king-aedred/planty/docs/hardware.md

# Planty – Bauteilliste

| Bauteil | Funktion | Preis |
|---|---|---|
| ESP32 | Mikrocontroller (WLAN + Bluetooth) | 5€ |
| Capacitive Soil Moisture Sensor V2.0 | Bodenfeuchtigkeit messen | 2,50€ |
| XIAO Logger HAT mit DS18B20 & BH1750 | Temperatur, Licht usw. | 7€ |
| LIPO 3,7 V Akku 400mAh  | Akku | 6€ |
| Perfboard | Platine für Handmontage (Beta) | |
| Gehäuse (3D-Druck) | Schutz/Optik des Sensors | |
| Jumper-Kabel / Stiftleisten | Verkabelung | Gesamt: 20,5€ |
