king-aedred/planty/docs/SCREENS.md

# Callgreen App: Screens und Features

Stand: 2026-10-26 · Arbeitsliste für die UI-Runde. Gebaut wird in der Reihenfolge unten (User-Flow), Screen für Screen im Browser (`http://100.86.32.59:8099`).

## Entscheidungen (26.10.)

- **4 Tabs** bleiben: Pflanzen, Nachrichten, Sensoren, Einstellungen.
- **Sensor-Detail** wird eine eigene Seite. Das Pflanzen-Detail zeigt nur noch eine Sensor-Zeile mit Link.
- **Gießen:** keine Knöpfe „Jetzt gießen“/„Gegossen“. Kritische Pflanzen zeigen einen Hinweis („Braucht Wasser“). Quittieren + Kontrolle per Messung (Charakter-Reaktion) ist ein späteres Feature.
- **Filter und Standort:** später, zusammen. Filter-Knopf vorerst entfernen.
- **Pflanze ohne Sensor:** bleibt erlaubt, braucht einen eigenen Zustand.
- **„Passwort vergessen“:** wird jetzt gebaut.
- **Chips „Automatische Analyse“ / „Sofort-Tipps“:** gewollt, aber erst später mit echtem Inhalt. Vorerst entfernen.
- **Entfällt:** „Messzeit“ in den Einstellungen (gespeichert, aber nirgends genutzt; die Firmware hat einen festen Messplan), Burger-Menü.

## Screens (Soll), in Bau-Reihenfolge

Fertig (UI, 28.10.): 0 Willkommen, 1 Login, 2 Registrieren, 2b Code, 3 Passwort vergessen.
Baseline 29.10.: Onboarding-UI (4) komplett inkl. Kanäle; Dashboard (6) als adaptives Layout (1 Pflanze = Bühne, wenige = Bühne + Liste, viele = Suche + „Braucht dich“/„Alles gut“), Gesamtbild mit Tab-Leiste, Nachrichten, Sensoren, Einstellungen unter `/preview/7-app` (Beispieldaten, noch nicht verdrahtet).
Detailseiten 29.10. (im Gesamtbild antippbar): Pflanzen-Detail, Pflanzen-Einstellungen, Sensor-Detail, Profil, Benachrichtigungen; Pflanze hinzufügen und Sensor koppeln als Modi des Onboarding-Ablaufs (`mode`). Bausteine in `components/screens/`. Echte Clerk-Wege für Passwort vergessen und Code beim Login noch mit Testkonto prüfen.

**Phase A (31.10.): echte App verdrahtet.** Tabs (Dashboard adaptiv, Nachrichten, Sensoren, Einstellungen) mit Markenleiste, Pflanzen-Detail mit Verlauf aus `device_readings`, Pflanzen-Einstellungen, Sensor-Detail mit Befehlen, Profil (Clerk), Benachrichtigungen (Kanäle, Erreichbarkeit, Max/Tag), Onboarding nach der ersten Anmeldung (`users.onboarding_done`), Pflanze hinzufügen, Sensor koppeln/zuordnen, Erfolge aus den Tagesauswertungen. Push-Erlaubnis nur noch im Onboarding bzw. beim Einschalten. Offen für Phase B (Testtag mit Handy + Sensor): neue BLE-Schritte statt des bestehenden Kopplungs-Bausteins, Push/Telegram am Gerät prüfen, Befehle am echten Sensor.

**Phase B (31.10.): echte Kopplung hinter den neuen Schritten.** `components/onboarding/ble-pairing.ts` (`createBlePairing`, Logik aus dem alten `ble-provisioning.tsx`, das samt `legacy-pairing.tsx` entfernt ist) erfüllt `PairingAdapter`; `hooks/use-ble-pairing.ts` verdrahtet Claim-Token (`devices.createClaimToken`) und Backend-Rückmeldung (`devices.getClaimStatus`). Onboarding, Pflanze hinzufügen und Sensor koppeln nutzen es; die Vorschau bleibt bei `mockPairing`. Fälle: Berechtigungen (Bluetooth, Android auch Standort) mit Erklärung und Fehlertext im Einsteck-Schritt, mehrere Sensoren → Auswahl, Verbinden scheitert → konkreter Grund + „Nochmal suchen“, Sensor schon im WLAN → WLAN-Schritt entfällt („war schon verbunden“), falsches Passwort / WLAN nicht gefunden / Claim abgelehnt → zurück zur WLAN-Eingabe mit Text, BLE reißt ab → Backend-Rückfallebene 45 s. Noch nicht am Gerät getestet (Testtag).

| # | Screen | Inhalt | Änderung gegenüber heute |
|---|---|---|---|
| 0 | **Willkommen (App-Start)** | Logo-Animation (Mitte → oben), „Hast du schon ein Konto?“ → Registrieren / Anmelden | **neu**; Start ohne Login landet hier statt im Login |
| 1 | Login | E-Mail, Passwort, Google/Apple | Logo/Texte „Callgreen“; SSO prüfen (geht heute nicht) |
| 2 | Registrieren | Benutzername, E-Mail, Passwort ×2, Nutzungsbedingungen (Link → Blatt von unten, Inhalt folgt in `constants/legal.ts`) | Überschrift „Gib deiner Pflanze eine Stimme!“, Platzhalter raus |
| 2b | **Code eingeben** | 6 Ziffernfelder, prüft automatisch, wackelt bei falschem Code, „Code erneut senden“, „Zurück“ | **neu**; gemeinsam für Registrieren (E-Mail) und Login (neues Gerät) |
| 3 | **Passwort vergessen** | E-Mail → Code → neues Passwort → angemeldet (Clerk `resetPasswordEmailCode`); Link im Login | **neu** |
| 4 | Einstieg / erste Pflanze | Willkommen → Sensor koppeln → Art + Name → fertig | ohne Burger-Menü; klarer Schrittfortschritt |
| 5 | Sensor koppeln (BLE) | USB-Hinweis, Scan, WLAN (Liste, Vorschlag, QR), Warten, Fehler | anzeigen, mit welchem WLAN der Sensor schon verbunden ist; „Planty“-Texte raus |
| 6 | Dashboard (Tab Pflanzen) | Kompakt/Detail, Avatar, Messwerte, letzte Nachricht, „x von y Sensoren aktiv“, Pflanze hinzufügen | Filter, Standort, Gieß-Knöpfe, Deko-Chips raus; Zustand „ohne Sensor“; kritisch = Hinweis |
| 7 | Pflanzen-Detail | 3 Messwerte, Verlauf (Messgröße, Zeitraum, eigener Bereich), Charakter, Sensor-Zeile → Sensor-Detail | Sensor-Aktionen ausgelagert |
| 8 | Pflanzen-Einstellungen | Name, Art, Persönlichkeit, Schwellenwerte, **Pflanze löschen** | Löschen neu (heute nur über „Sensor übertragen“) |
| 9 | Pflanze hinzufügen | Mit/ohne Sensor, freier Sensor oder von anderer Pflanze übertragen, Art, Name | Texte/Optik |
| 10 | **Sensor-Detail** | Akku (%), WLAN/Signal, Firmware, zuletzt gesehen, nächste Messung, zugeordnete Pflanze; Jetzt messen, WLAN ändern, Werkseinstellungen, Entfernen | **neu** (Inhalt aus Pflanzen-Detail) |
| 11 | Sensoren (Tab) | Liste: im Einsatz / frei, → Sensor-Detail, Sensor koppeln | Zeile öffnet Sensor-Detail |
| 12 | Nachrichten (Tab) | Liste, gelesen/ungelesen, Systemhinweise (offline, Akku) | Optik, Leerzustand |
| 13 | Einstellungen (Tab) | Benachrichtigungen (Kanäle je Zustand, Ruhezeiten, Max/Tag), Telegram, Profil, Telefonnummer, Ausloggen, Dev Tools (nur Dev) | „Messzeit“ raus |

Übergänge Willkommen → Login/Registrieren und Login ↔ Registrieren ↔ Code: Logo bleibt/gleitet, nur die Box blendet aus und ein (`components/auth/auth-shell.tsx`).

Nebenher: Start-Spinner mit Timeout (~15 s, „Keine Verbindung“ + „Erneut versuchen“), Login-Pflicht für alle Routen im Web, restliche „Planty“-Texte.

Unverändert / außerhalb der Runde: Fake-Anruf (`demo-call`), Dev Tools, Vorschau-Seiten.

## Onboarding (Plan 28.10.)

Kommt einmalig nach der ersten Anmeldung (Feld `onboarding_done` am Nutzer; bestehende Konten mit Pflanzen gelten als fertig). Optik wie Auth: Kopf bleibt, jeder Schritt tauscht nur die Box, oben Fortschritt.

```
O1  „Schön, dass du da bist!“  [Ich habe einen Sensor] [Nur eine Pflanze anlegen] [Später → leeres Dashboard]
Sensor-Pfad:  A1 USB anstecken → A2 Suchen → A3 WLAN + Passwort → A4 Verbinden … → A5 „Sensor verbunden!“
Beide Pfade:  P1 Art suchen/selbst eingeben + Name (frei; leer = Standardname der Art)
              P2 Persönlichkeit (Fröhlich / Grummelig / Gelassen)
              P3 „Wie darf <Name> sich bei dir melden?“ Push · Telegram · Anruf (kommt bald)
                 → je gewähltem Kanal dessen Einrichtung (Push-Erlaubnis, Telegram-Code)
              P4 „<Name> ist bereit!“ → Übergang ins Dashboard (ohne Sensor: Hinweis, dass Messwerte fehlen)
```

Bausteine einmal bauen und wiederverwenden: A1–A5 = Screen 5 (Sensor koppeln), P1–P2 = Screen 9 (Pflanze hinzufügen). Vorschau mit simuliertem BLE/WLAN/Telegram.

Bau-Etappen: 1) Rahmen + O1 + P1–P4 (Pflanzen-Pfad) · 2) A1–A5 (Sensor-Pfad, BLE-Logik aus `ble-provisioning.tsx`) · 3) Kanäle (Push, Telegram) · 4) echte Weiche nach dem Login + `onboarding_done` im Backend.

## Später

- Gießen quittieren mit Kontrolle über die nächste Messung und Charakter-Reaktion
- Standort pro Pflanze + Filter/Sortierung im Dashboard
- „Automatische Analyse“ / „Sofort-Tipps“ mit echtem Inhalt
- Anruf als Kanal
