king-aedred/planty/hardware/enclosure/animation_frames.png

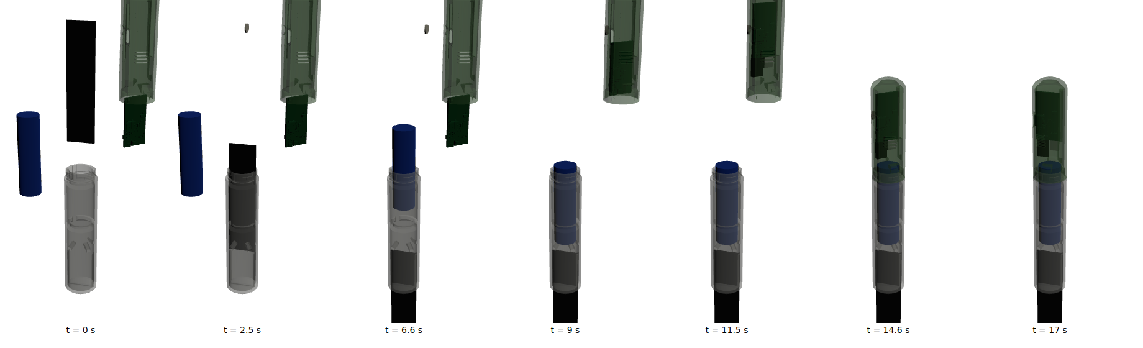
hardware/enclosure/animation_frames.png
