king-aedred/planty/hardware/enclosure/window.stl

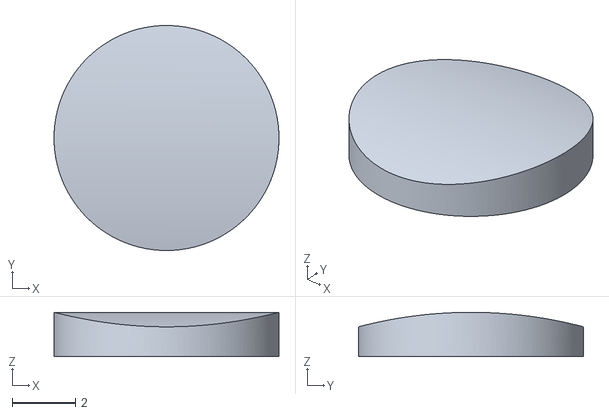
[picture p2: CAD file, 2026-11-04]
hardware/enclosure/window.stl
7.10 x 7.10 x 1.40
