king-aedred/planty/hardware/enclosure/head.stl

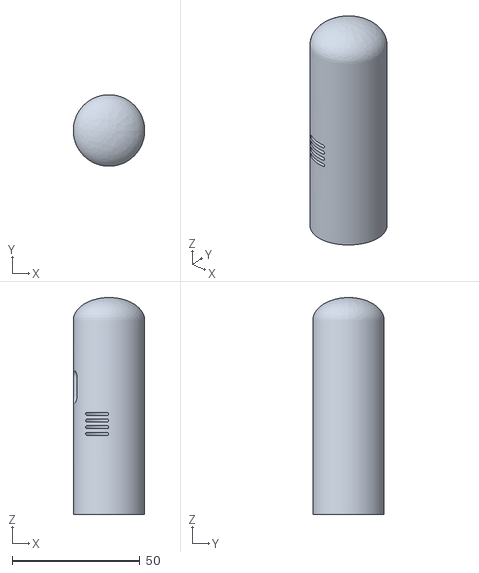
[picture p3: CAD file, 2026-11-04]
hardware/enclosure/head.stl
28.0 x 28.0 x 85.0
