king-aedred/planty/hardware/enclosure/case.step

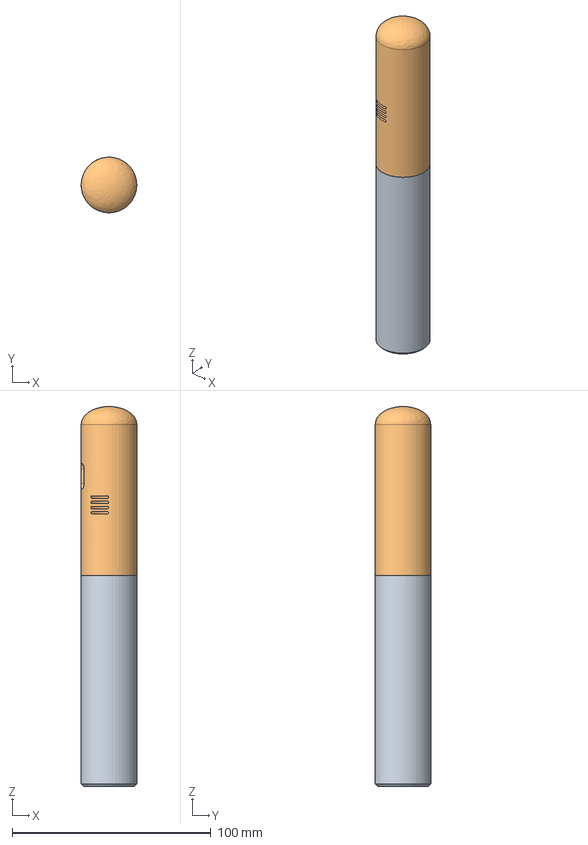
[picture p4: CAD file, 2026-11-04]
hardware/enclosure/case.step
28.0 x 28.0 x 191.0 mm
