king-aedred/planty/hardware/enclosure/body.stl

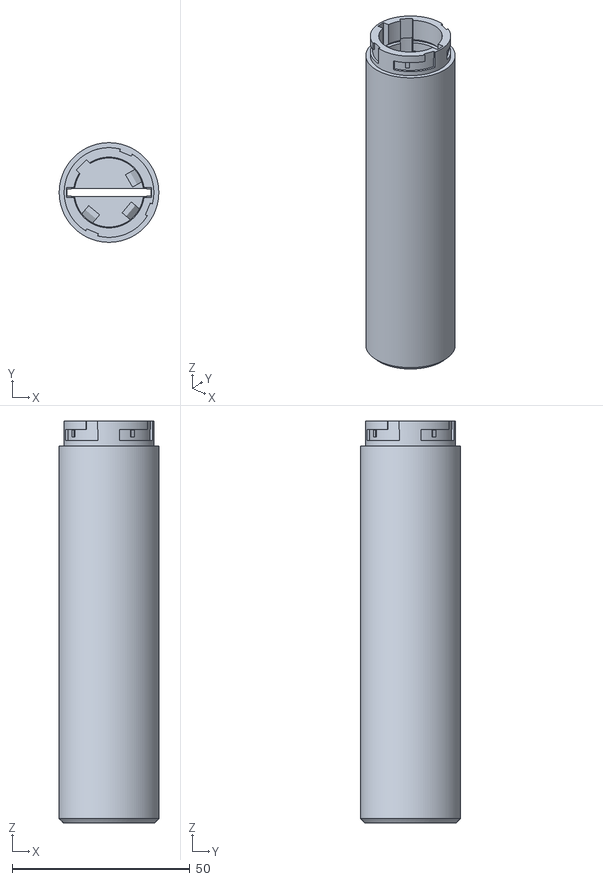
[picture p5: CAD file, 2026-11-04]
hardware/enclosure/body.stl
28.0 x 28.0 x 113.0
