king-aedred/planty/(commit log)

2026-06-27 feat: fastapi backend + convex readings endpoint + fake sensor
2026-06-28 feat: clerk auth + users/sensors/plants convex schema + erster login
2026-06-28 feat: user wird nach login automatisch in convex angelegt
2026-06-28 feat: dev mode + burger menu + sensor simulation + alle testszenarien für susd
2026-06-29 feat: multi-plant support, sensor transfer, dev mode single/multi sensor
2026-06-29 fix: timestamp auf sekunden, updateLastSeen in http.ts und devmode
2026-06-30 feat: telegram bot integration, connect flow, webhook
2026-07-01 feat: sensor status anzeige, message types, kontaktzeitfenster, chart wip
2026-07-02 feat: sensor problem endpoint, system-notifications n8n workflow, sensor status reset
2026-07-02 feat: pflanzendatenbank, 95 pflanzen, suche im onboarding und add-plant, lufttemperatur label
2026-07-02 fix: sensor/problem endpoint mit bearer token abgesichert
2026-07-04 feat: battery_voltage_median in daily_summaries, 18 einzel-readings firmware
2026-07-04 feat: moisture/temperature/light states im n8n payload, dimension-spezifische nachrichten
2026-07-04 chore: eas.json und app.json hinzugefügt
2026-08-28 Implement Planty onboarding and provisioning flow
2026-10-16 Backend: Firmware-v7-Vertrag (Claim, Batch, Befehle, OTA, Hinweise)
    - Onboarding: createClaimToken, getClaimStatus, POST /device/claim; Tokens nur als SHA-256-Hash
    - Geraete-Auth per Bearer fuer /readings, /logs und alle v7-Endpunkte (401 nur bei ungueltigem Token)
    - POST /readings/batch: idempotent ueber (device_id, seq), Auswertung nur der neuesten Messung,
    null-Werte und Sensorfehler (moisture_raw 0), Config pro Sensor, OTA-Angebot, Rollback-Meldung
    - Befehlskanal: device_commands, GET /device/commands, POST /device/commands/ack, App-Mutationen,
    removeSensor, Admin-Testhilfen; WLAN-Passwort wird bei Ack/Ablauf geloescht
    - OTA: firmware_releases, /firmware/latest, /firmware/file ueber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
2026-10-16 App: BLE-Onboarding ueber ESP-IDF-Provisioning, Sensorbefehle
    - BLE-Onboarding mit @orbital-systems/react-native-esp-idf-provisioning (Security 1, PoP aus
    EXPO_PUBLIC_ESP_POP), Custom-Endpunkte claim und status, Retry ohne erneute WLAN-Daten,
    Backend-Nachfrist ueber getClaimStatus, Hinweis wenn der Sensor schon online war
    - react-native-ble-plx entfernt
    - Sensor-Bereich in status.tsx: Jetzt aktualisieren, WLAN aendern, Sensor entfernen
    - useDeviceCommand-Hook mit Texten fuer detail-Werte
    - Anzeige fehlender Temperatur- und Lichtwerte (Platzhalter, Linienunterbrechung)
    - Sensor entfernen in der Pflanzenliste ueber removeSensor
    - WLAN-QR-Scanner und SSID-Vorschlag, Standard 1 Benachrichtig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
2026-10-16 Firmware d1_mini: uncommitteter Stand vor der v7-Umstellung
2026-10-22 App: Redesign Tamagui 3 / Stitch-Theme
    - Tamagui 3 mit Theme aus dem Theme Builder (Preset Violet) und
    semantischer Schicht nach dem Stitch-Template, Dark und Light
    - Tab-Navigation (Pflanzen, Nachrichten, Sensoren, Einstellungen)
    - neue Bausteine in components/ui und components/plants
    - alle Screens umgestellt, alte Colors/Theme-Hooks und Template-Reste entfernt
    - Pressability-Shim fuer Tamagui 3 auf RN 0.81
    Auf echten Geraeten noch nicht getestet.
2026-10-23 Firmware 7.0.1: SNTP-Anfrage im Akkubetrieb neu anstossen
    Nach dem Aufwachen geht die erste SNTP-Anfrage oft verloren. lwIP fragt
    erst nach 15 s erneut, das Sync-Fenster war aber nur 5 s lang. Folge:
    seit dem 19.10. kein Sync mehr, Uhr ca. 34 min voraus.
    Jetzt wird die Anfrage alle 2 s neu gesendet, Fenster 9 s. Log zeigt
    Dauer und Anzahl der Anfragen.
2026-10-23 Firmware 7.0.2: set_wifi stellt altes WLAN nach Fehlschlag wieder her
    Nach einem fehlgeschlagenen set_wifi (z. B. falsches Passwort) verbindet
    die STA noch mit den neuen Daten. esp_wifi_set_config() lehnte die alten
    Daten deshalb ab ("sta is connecting"), das Geraet blieb mit den falschen
    Daten im RAM haengen und war offline. Zusaetzlich haette net_wifi_commit()
    die aktuelle, falsche Konfiguration ins NVS geschrieben, sobald das Setzen
    geklappt haette.
    Jetzt wird der Verbindungsversuch vor dem Setzen immer abgebrochen, und
    net_wifi_restore() schreibt die bisherigen Daten direkt ins NVS.
2026-10-23 Firmware 7.0.8: config-Randwerte (z. B. low_battery_v 4.2) nicht mehr ablehnen
    Die Grenzen sind float, der Wert aus dem JSON double. 4.2 > 4.2f, deshalb
    wurde der erlaubte Hoechstwert als ungueltig verworfen.
2026-10-23 Firmware 7.0.9: erfolgreiches set_wifi dauerhaft speichern
    Die neuen Daten wurden nur im RAM gesetzt und spaeter mit unveraenderter
    Konfiguration erneut gesetzt, um sie ins NVS zu uebernehmen. Das speichert
    nicht dauerhaft: nach einem Neustart war wieder das alte WLAN aktiv
    (auf Hardware beobachtet).
    Jetzt gehen die neuen Daten direkt ins NVS. Die bisherigen Daten werden
    vorher unter callgreen/wifi_prev gesichert. Fehlschlag: alte Daten
    zurueckschreiben. Stromverlust waehrend des Tests: net_init stellt beim
    naechsten Start aus der Sicherung wieder her.
2026-10-23 Akkustand in Prozent, Werkseinstellungen in der App
    - convex/battery.ts: Kennlinie 18650 (3,2 V = 0 %, 4,15 V = 100 %) und
    Glaettung (faellt nur, steigt nur nach dem Laden), gespeichert als
    sensors.battery_pct mit Nachkommastelle
    - App: Akkuanzeige in der Pflanzen-Detailseite und im Tab Sensoren
    - App: Knopf "Auf Werkseinstellungen zurücksetzen" (requestFactoryReset)
    - getSensorStatus wirft fuer fremde/entfernte Sensoren nicht mehr,
    sondern liefert "unbekannt"
2026-10-23 Firmware 7.0.10: Toleranz fuer zu fruehes Aufwachen
    Ohne 32-kHz-Quarz wacht das Geraet oft Sekunden vor dem Slot auf. Folgen
    im Backoff-Test: (1) next_wifi_at lag 3 s in der Zukunft, der WLAN-Versuch
    fiel einen ganzen Slot aus (effektiv 60 statt 30 min). (2) Nach Aufwachen
    um 15:29:27 schlief das Geraet 33 s bis 15:30 und mass doppelt.
    Jetzt gilt ein Slot oder Backoff-Zeitpunkt, der weniger als 120 s entfernt
    ist, als erreicht.
2026-10-26 Docs: Nachtdaten 7.0.10, Screen-Liste fuer die UI-Runde
2026-10-28 App: Onboarding (Start, Sensor koppeln simuliert, Pflanze, Persoenlichkeit, Kanaele)
    - Sensor-Schritte mit Pairing-Schnittstelle, Vorschau simuliert
    - schwebende Dropdowns fuer Pflanzenart und WLAN, QR-Alternative
    - Kopf (Logo + Fortschritt) gleitet bei Hoehenwechsel der Box
2026-10-29 App: Baseline UI-Gesamtbild (Onboarding-Kanaele, Dashboard, Navigation, Konto)
    - Onboarding Etappe 3: Push, Telegram, Anruf einrichten (Vorschau simuliert)
    - Dashboard aufgeraeumt: ohne Filter/Standort/Giess-Knoepfe/Chips, Zustand ohne Sensor, Hinweis bei kritisch
    - Dashboard-Varianten 6v1-6v4, adaptives Dashboard (1/3/12/100 Pflanzen)
    - Vorschau Gesamtbild /preview/7-app mit Tab-Leiste, Nachrichten, Sensoren, Einstellungen
    - TabBarView als navigationsfreier Baustein
2026-10-29 Docs: SCREENS.md mit Onboarding-Plan und UI-Baseline
2026-10-29 App: Detailseiten, Kopf-Varianten, Erfolge in der Vorschau
    - Pflanzen-Detail, Pflanzen-Einstellungen, Sensor-Detail, Profil, Benachrichtigungen (components/screens)
    - Pflanze hinzufuegen / Sensor koppeln als Modi des Onboarding-Ablaufs
    - Markenleiste als App-Kopf, Erfolge bei einer Pflanze
    - Bausteine: BottomSheet, Switch, HistoryChart, CharacterPicker
2026-10-29 App: Phase A - neue Screens mit echten Daten verdrahtet
    Backend (additiv):
    - users.onboarding_done + completeOnboarding (Kanaele uebernehmen)
    - createPlant mit Persoenlichkeit, assignSensorToPlant, updatePlantSettings mit Art
    - device_readings.getReadingsSince fuer den Verlauf
    App:
    - Tabs: adaptives Dashboard, Nachrichten, Sensoren, Einstellungen mit Markenleiste
    - Pflanzen-Detail (Verlauf aus Messwerten), Pflanzen-Einstellungen, Sensor-Detail mit Befehlen,
    Sensor zuordnen, Profil (Clerk), Benachrichtigungen
    - Onboarding nach erster Anmeldung, Pflanze hinzufuegen, Sensor koppeln (BLE bis Phase B ueber den
    bestehenden Baustein)
    - Erfolge aus Tagesauswertungen; Push-Erlaubnis nicht mehr b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
2026-11-01 App: Phase B - echte BLE-Kopplung hinter den neuen Schritten
    createBlePairing (Logik aus ble-provisioning.tsx) erfuellt PairingAdapter,
    useBlePairing verdrahtet Claim-Token und Backend-Rueckmeldung. Neue Faelle:
    Berechtigungen, mehrere Sensoren, Verbindungsfehler, Sensor schon im WLAN.
    Alter Kopplungs-Baustein entfernt.
2026-11-04 Backend: Kontaktzeitfenster in deutscher Ortszeit statt UTC
    processor.ts (Pflanzenmeldungen) und sensor_alerts.ts (Offline/Akku) rechnen die
    aktuelle Stunde jetzt in Europe/Berlin, inkl. Sommer-/Winterzeit.
2026-11-04 Hardware: Gehäuse-Entwurf v7 (runde Kapsel, Bajonett) als parametrisches Modell
    CadQuery-Modell für Rohr, Kopf und Fenstereinsatz um Platine v3, 18650 und
    Bodensensor; Druckdateien (STL/STEP), Prüflauf für Endlagen und Einbauwege
    (check_all.py), GLB-Export für Blender inkl. Zusammenbau-Animation.
    GLBs sind ignoriert und werden per Skript erzeugt.
2026-11-04 Gehäuse: Fenster in Druckausrichtung, 45°-Schräge über dem Platinenhaken
    window.stl liegt flach auf der Innenseite (direkt druckbar). Unter Schiene und
    Anschlag über dem Schnapphaken eine 45°-Schräge statt waagerechtem Überhang;
    Hohlraum und Federweg der Hakenzunge bleiben frei.
